oioihoihoih/mobile-humidity-control-robot/docs/README.md

# 프로젝트 문서 안내

이 디렉터리는 이동형 습도 제어 로봇의 현재 기준 문서를 모읍니다. 현재 기준은 **구역 센서 2대 + 자동차 Uno 3대 + M1~M4 전·후진 라인 주행 + RFID 구역 인식 + Python/MySQL 서버**입니다.

[저장소 첫 화면으로 돌아가기](../README.md)

## 권장 읽기 순서

| 순서 | 문서 | 확인할 내용 |
| --- | --- | --- |
| 1 | [아키텍처](architecture.md) | 구성 요소, 통신 경로, 임무 상태와 안전 불변조건 |
| 2 | [하드웨어](hardware.md) | 3-Uno 역할, 핀 연결, I2C와 전원 분리 |
| 3 | [설치와 실행](setup.md) | 로컬 서버, MySQL, 펌웨어 설정과 신뢰 LAN 연결 |
| 4 | [HTTP API](api.md) | 센서 입력, 로봇 명령·ACK, 대시보드와 제어 API |
| 5 | [테스트](testing.md) | 자동 검사 명령과 각 검증이 증명하는 범위 |
| 6 | [한계](limitations.md) | 아직 검증되지 않은 실차·전력·네트워크 위험 |

특정 작업을 수행할 때는 다음 문서도 함께 봅니다.

- [SimulIDE 3-Uno 프록시](../simulide/THREE_UNO_PROXY.md)
- [원격 배포 절차](operations/remote-deployment.md)
- [원격 작업 인계](operations/remote-handoff.md)
- [문서·저장소 구성 참고 자료](references.md)
- 서버 실행 후 제공되는 시스템 로직 화면: `/logic`

## 검증 표현

이 프로젝트는 아래 용어를 구분해서 사용합니다.

| 표현 | 뜻 |
| --- | --- |
| 자동 검사 통과 | Python·호스트 C++와 체크인 SimulIDE artifact가 각자 정의된 계약을 만족함; 현재 실물 DHT/HC 핀 배치 검증은 별도 |
| 컴파일 통과 | 대상 보드용 바이너리를 만들 수 있음; 실물 동작을 뜻하지 않음 |
| 벤치 검증 | 정지 상태 또는 바퀴를 띄운 상태의 연결·기본 통신·안전 출력 확인 |
| 실차 검증 | 바닥 트랙에서 이동, RFID 판독, 제동과 복귀까지 관찰 |
| 부하 검증 | 실제 모터·가습·제습 부하의 전류, 발열과 동작 효과를 측정 |

현재 실물 증거는 **이전 3-Uno·2모터 구성의 제한적 벤치 기록**에 한정됩니다. M3/M4를 추가한 현재 4모터 구성은 바퀴 공중 시험부터 다시 검증해야 하며, 소스 모델이나 시뮬레이션 통과를 실물 성공으로 표현하지 않습니다.

## 문서 유지 원칙

- Wi-Fi 자격증명, 제어 토큰과 데이터베이스 비밀번호는 예제 파일이나 문서에 넣지 않습니다.
- 특정 PC의 절대 경로, 내부 주소, 시리얼 포트와 RFID UID를 기준 문서에 고정하지 않습니다.
- 실행 예시는 저장소 루트 기준 상대 경로와 `<server-host>` 같은 자리표시자를 사용합니다.
- 상태 표에는 무엇을 시험했는지와 무엇을 시험하지 않았는지를 함께 기록합니다.
- 아키텍처가 바뀌면 [아키텍처 문서](architecture.md), API가 바뀌면 [API 문서](api.md), 검증 범위가 바뀌면 [테스트](testing.md)와 [한계](limitations.md)를 같은 변경에서 갱신합니다.
- 현재 로컬 flash/SRAM은 SensorUno `27,808B / 1,428B`, MotorUno `11,346B / 464B`, ActuatorUno `12,534B / 532B`입니다. SensorUno CI 상한 `29,000B / 1,500B`와 RFID·I2C·HTTP 루프 지연을 함께 확인합니다.
