oioihoihoih/mobile-humidity-control-robot/docs/assets/dashboard-preview.png

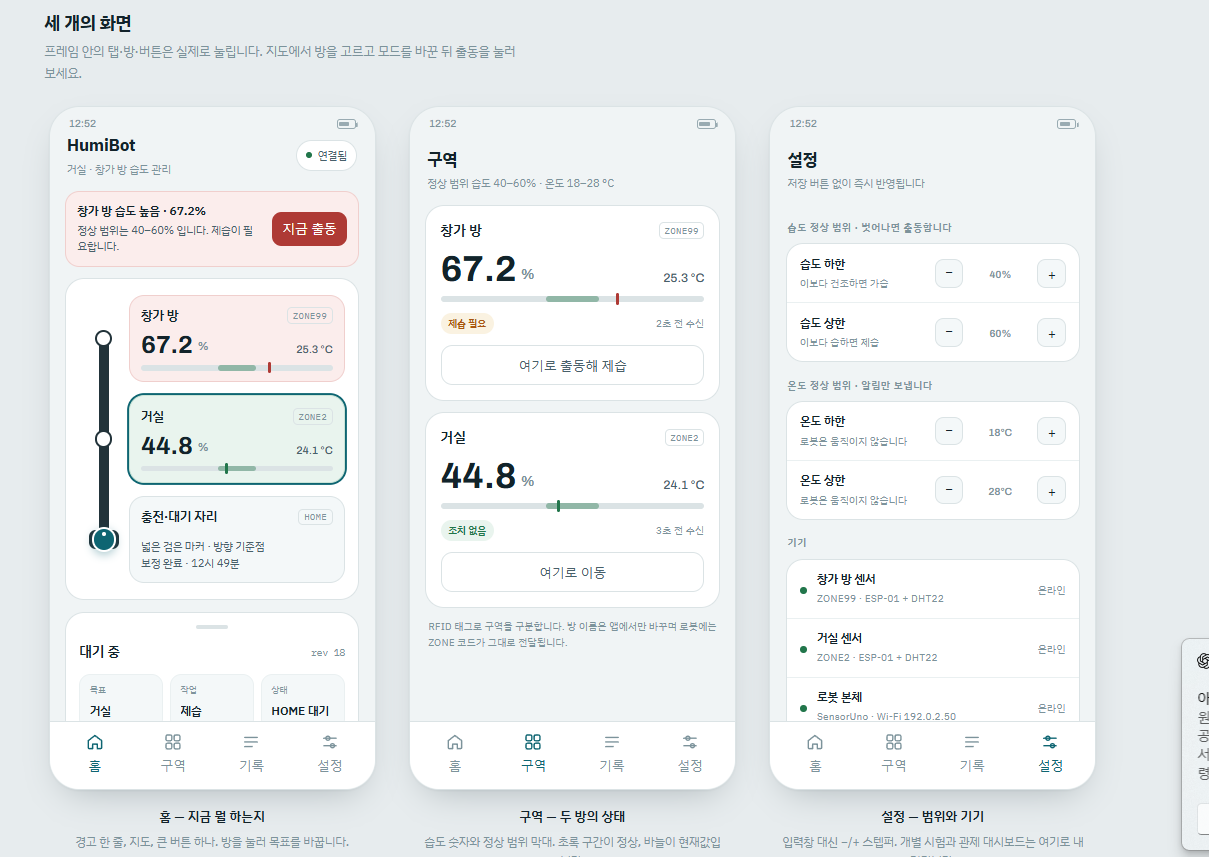
docs/assets/dashboard-preview.png
