oioihoihoih/mobile-humidity-control-robot/firmware/uno_robot_esp01_rfid_relay/robot_network_config.example.h

#pragma once

#define ROBOT_WIFI_SSID "YOUR_WIFI_SSID"
#define ROBOT_WIFI_PASSWORD "YOUR_WIFI_PASSWORD"
#define ROBOT_SERVER_HOST "192.0.2.10"
#define ROBOT_SERVER_PORT 8000

// Replace these example values with the UIDs read from your own station tags.
#define ROBOT_HOME_UID "01 23 45 67"
#define ROBOT_ZONE2_UID "AA BB CC DD"
#define ROBOT_ZONE99_UID "11 22 33 44"
