oioihoihoih/mobile-humidity-control-robot/(commit log)

2026-08-21 Add safe four-motor forward and reverse control
    [SoftwareMFRC522.cpp, SoftwareMFRC522.h, closed_loop_virtual_sim.py, motor_uno_i2c_proxy.ino, sensor_uno_3uno_proxy.ino, test_closed_loop_virtual_sim.py, test_home_calibration_closed_loop.py, test_motor_4wd_source.py]
2026-08-21 Distribute robot sensors across peripheral Unos
    Move the car DHT22 to ActuatorUno and the rear ultrasonic safety loop to MotorUno, reducing SensorUno memory pressure while preserving route authority and exact I2C acknowledgements. Update diagnostics, simulation artifacts, documentation, and regression coverage.
2026-08-21 Move rear ultrasonic to Motor Uno analog pins
2026-08-21 Revert "Keep only production Uno firmware"
    This reverts commit 9e0ee870529b0469ac597450507f0f3c77613259.
    [SoftwareMFRC522.cpp, SoftwareMFRC522.h, i2c_bus_diagnostic.ino, i2c_passive_release.ino, i2c_slave_diagnostic.ino, secrets.example.h, sensor_bus_release.ino]
2026-08-21 Fix mobile app control connection recovery
    [server.py, test_server_logic.py]
